Parradan/Control-Temperatura/Sin título.jpg

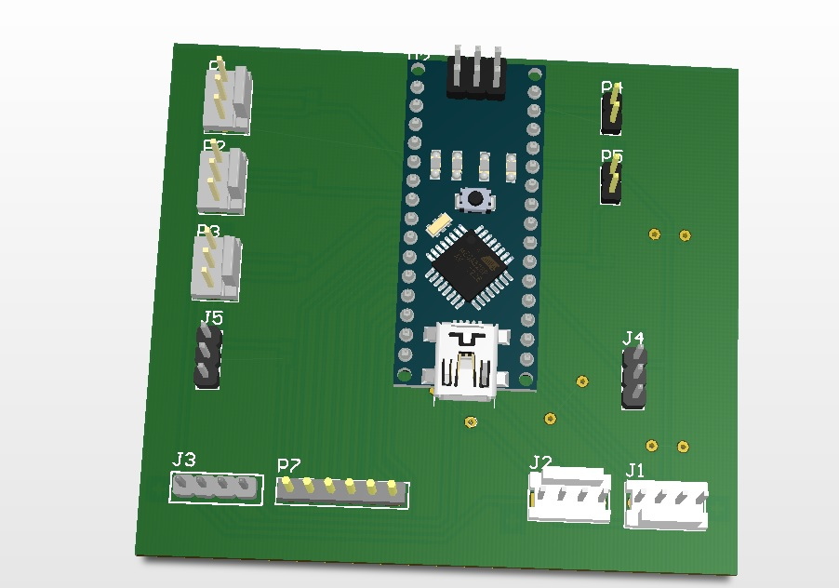
Sin título.jpg
