Parradan/Control-Temperatura/Sin título2.jpg

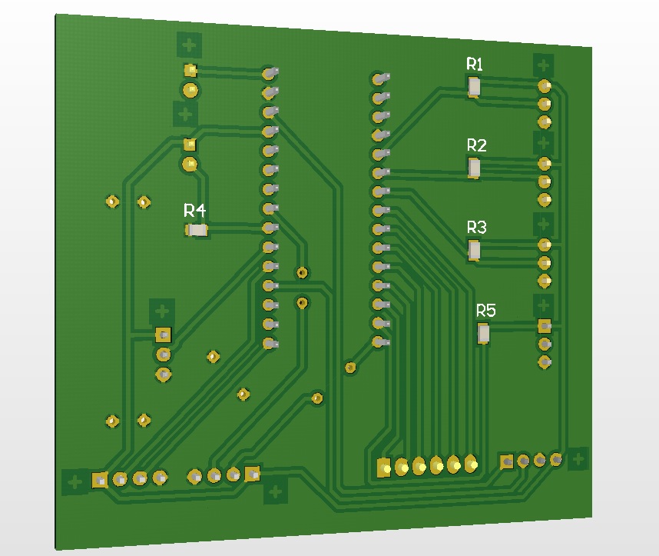
Sin título2.jpg
