Parradan/Control-Temperatura/(commit log)

2018-05-02 trabajo de cdm control de temperatura,con el ultimo codigo de arduino en funcionamiento
2018-05-02 agrego los renders de la placa
2018-05-05 subo los cogigos que tenia en la carpeta de dropbox
